niyunjie/STM32-Based-Line-Tracking-Mobile-Robot/assets/docs/Component.xlsx

Comment | Description | Designator | Footprint | LibRef | Quantity
12pF | 贴片电容0402 | C1, C2 | c0402 | 0402贴片电容 | 2
0.1uF | 贴片电容0402 | C3, C6, C7, C8, C9 | c0402 | 0402贴片电容 | 5
10uF | 贴片电容0402 | C4, C5, C12, C13 | c0402 | 0402贴片电容 | 4
100uF | 1210贴片电容 | C10, C11 | 1210 | 1210贴片电容 | 2
10uF | 3216钽电容 | C14 | 3216 | 3216钽电容 | 1
立式XT30母头 | 立式XT30母头 | CN1 | CONN-TH_XT30U-M | 立式XT30母头 | 1
KF141R-2.54-2P | 接头 | CN2, CN3 | CONN-TH_2P-P2.54_KF141R-2.54-2P | KF141R-2.54-2P | 2
立式gh1.25 4pin | 立式gh1.25 4pin | CN4 | GH1.25 4P 立贴 | 立式gh1.25 4pin | 1
SS34B | 硝基特二极管 | D1 | SMA_L4.3-W2.6-LS5.2-RD | SS34二极管 | 1
PZ254V-11-03P | 2.54mm 1x3pin排针 | H1, H2, H3, H4, H5 | HDR-TH_3P-P2.54-V-M | 2.54mm 1x3pin排针 | 5
2.54mm排针 1x4P | 2.54mm排针 1x4P | H6, H7, H8 | HDR-TH_4P-P2.54-V-M | 2.54mm排针 1x4P | 3
10uH | 一体成型屏蔽电感，0530封装，额定电流3A | L1 | IND-SMD_L5.4-W5.2 | 0530屏蔽电感 | 1
10KΩ | 0402贴片电阻 | R1, R2 | R0402 | 0402贴片电阻 | 2
SW | 开关 | S1 | KEY_SMD | SW | 1
SS12D10G4 071 | 单刀双掷开关 | SW1 | SW-TH_SHOU-HAN_SS12D10G4 | SS12D | 1
STM32F103C8T6 | 单片机 | U1 | LQFP48 7X7_N | STM32F103C8T6 | 1
XL1507-5.0E1 | DC-DC BUCK芯片 | U2 | TO-252-5_L6.5-W5.6-P1.27-LS9.5-TL | XL1507-5.0E1 | 1
XC6201P332MR-HXY | 3.3V LDO | U3 | SOT-23-5_L3.0-W1.7-P0.95-LS2.8-BR | XC6201P332MR-HXY | 1
TB6612FNG(O,C,8,EL | 电机驱动 | U4 | SSOP-24_L8.4-W5.8-P0.65-LS7.8-BL | TB6612FNG(O,C,8,EL | 1
12MHz | 3225贴片晶振 | Y1 | OSC-3225-4P | 3225贴片晶振 | 1
