niyunjie/STM32-Based-Line-Tracking-Mobile-Robot/Tracking_Car/Core/Src/main.c

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
/* Includes ------------------------------------------------------------------*/
#include "main.h"
#include "dma.h"
#include "i2c.h"
#include "tim.h"
#include "usart.h"
#include "gpio.h"

/* USER CODE BEGIN Includes */
#include "motor.h"
#include "hcsr04.h"
#include "tracker.h" // ?????? tracker.h
#include "remote.h"
#include "ui.h"
#include "global_state.h"
#include <stdio.h>
#include "usart.h"
/* USER CODE END Includes */


void SystemClock_Config(void);
/* USER CODE BEGIN 0 */
uint32_t timer_ui = 0;
uint32_t timer_telemetry = 0;
/* USER CODE END 0 */

/**
  * @brief  The application entry point.
  * @retval int
  */
int main(void)
{

  /* MCU Configuration--------------------------------------------------------*/

  /* Reset of all peripherals, Initializes the Flash interface and the Systick. */
  HAL_Init();

  /* Configure the system clock */
  SystemClock_Config();

  /* Initialize all configured peripherals */
  MX_GPIO_Init();
  MX_DMA_Init();
  MX_I2C1_Init();
  MX_TIM1_Init();
  MX_TIM2_Init();
  MX_USART1_UART_Init();
  /* USER CODE BEGIN 2 */

UI_Init();
  Motor_Init();
  HCSR04_Init();
  Tracker_Init();
  Remote_Init(); // ????
  
  g_CarState = STATE_RUNNING;
  

  /* USER CODE END 2 */

  /* Infinite loop */
  /* USER CODE BEGIN WHILE */
  while (1)
  {
    /* USER CODE END WHILE */

    /* USER CODE BEGIN 3 */
		if (g_CarMode == MODE_AUTO) {
        // 自动模式下执行循迹
        Tracker_Loop(); 
    } 
    else if (g_CarMode == MODE_MANUAL) {
        // 手动模式下执行遥控
        Remote_ManualLoop();
    }

    // 2. 数据回传任务 (建议 50ms - 100ms 一次)
    // 必须频繁调用，因为 Remote_SendTelemetry 内部有 200ms 的非阻塞限流
    Remote_SendTelemetry(); 

    // 3. UI 刷新任务 (建议 100ms - 200ms 一次，避免占用过多 CPU)
    if (HAL_GetTick() - timer_ui >= 150) {
        timer_ui = HAL_GetTick();
        UI_Update();
    }
  
  }
  /* USER CODE END 3 */
}

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
/* USER CODE BEGIN 4 */

// ?????
#ifdef __GNUC__
#define PUTCHAR_PROTOTYPE int __io_putchar(int ch)
#else
#define PUTCHAR_PROTOTYPE int fputc(int ch, FILE *f)
#endif
PUTCHAR_PROTOTYPE {
  HAL_UART_Transmit(&huart1, (uint8_t *)&ch, 1, 10);
  return ch;
}

// ?? DMA ??
void HAL_UARTEx_RxEventCallback(UART_HandleTypeDef *huart, uint16_t Size) {
    Remote_UART_EventCallback(huart, Size);
}
void HAL_TIM_IC_CaptureCallback(TIM_HandleTypeDef *htim) {
    HCSR04_TimIC_Callback(htim);
}
/* USER CODE END 4 */
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
