niyunjie/STM32-Based-Line-Tracking-Mobile-Robot/Tracking_Car/Core/Inc/main.h

#define ENA_Pin GPIO_PIN_0
#define ENA_GPIO_Port GPIOA
#define ENB_Pin GPIO_PIN_1
#define ENB_GPIO_Port GPIOA
#define IN1_Pin GPIO_PIN_2
#define IN1_GPIO_Port GPIOA
#define IN2_Pin GPIO_PIN_3
#define IN2_GPIO_Port GPIOA
#define IN3_Pin GPIO_PIN_4
#define IN3_GPIO_Port GPIOA
#define IN4_Pin GPIO_PIN_5
#define IN4_GPIO_Port GPIOA
#define Echo_Pin GPIO_PIN_10
#define Echo_GPIO_Port GPIOA
#define Trig_Pin GPIO_PIN_11
#define Trig_GPIO_Port GPIOA
