niyunjie/STM32-Based-Line-Tracking-Mobile-Robot/(notices)

Notices in the files:
Tracking_Car/Core/Src/main.c:
Copyright (c) 2025 STMicroelectronics.
All rights reserved.
This software is licensed under terms that can be found in the LICENSE file
